fjvva/ecu-tool/Schematics/Hardware V3/HWV3.png

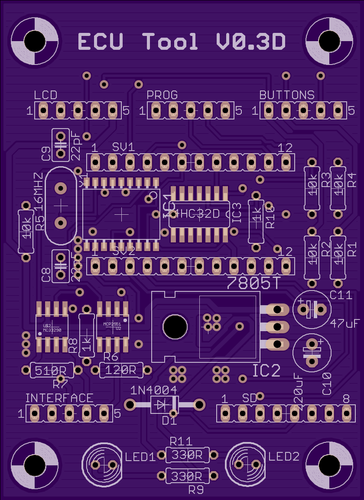
Schematics/Hardware V3/HWV3.png
