fjvva/ecu-tool/Schematics/Portable_outside.JPG

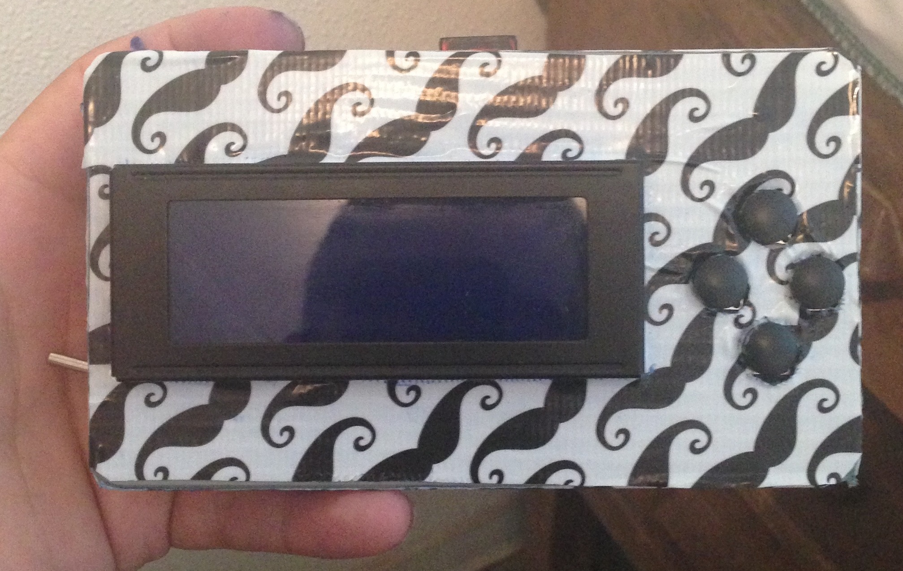
Schematics/Portable_outside.JPG
