fjvva/ecu-tool/Schematics/obd_cable_drawing.png

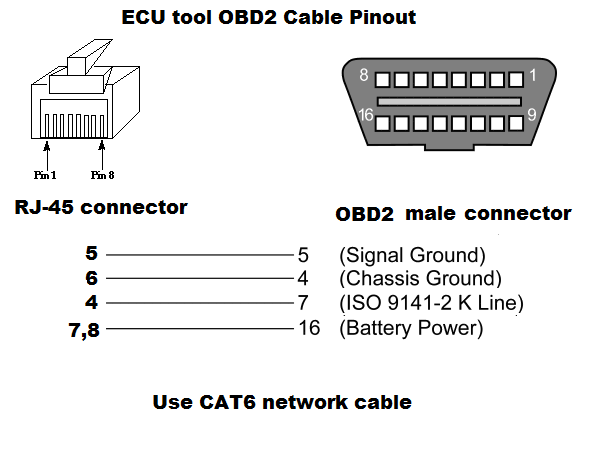
Schematics/obd_cable_drawing.png
