fjvva/ecu-tool/Schematics/Portable_Inside.JPG

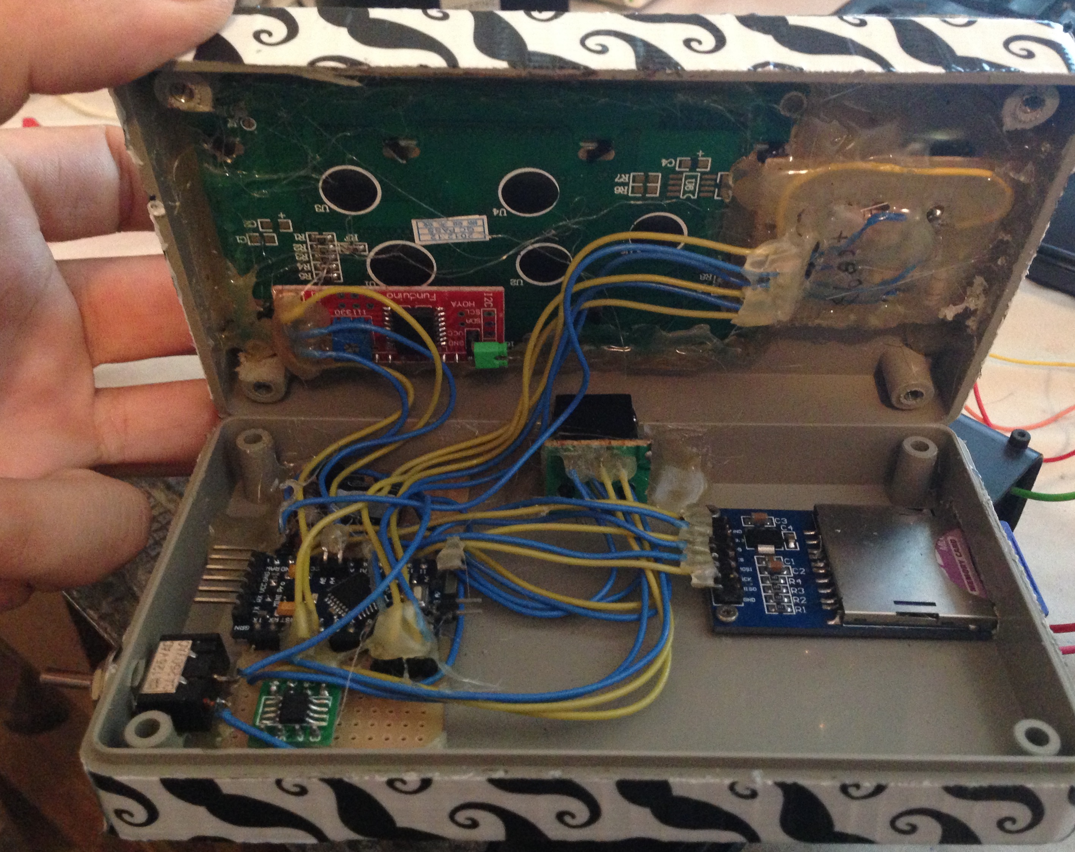
Schematics/Portable_Inside.JPG
