fjvva/ecu-tool/Schematics/programming_cable_drawing.jpg

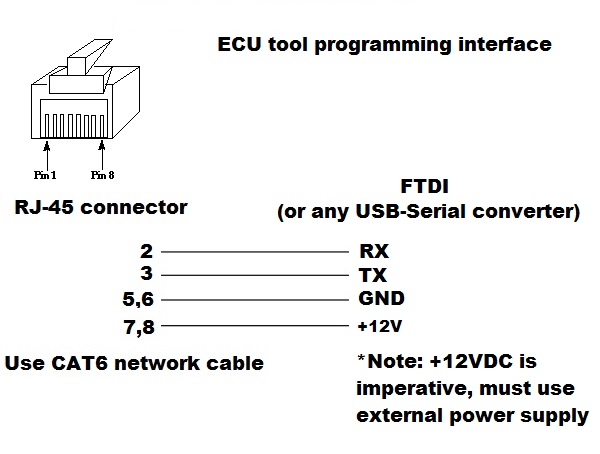
Schematics/programming_cable_drawing.jpg
