fjvva/ecu-tool/Schematics/Hardware V3/ECU tool V0.3.pdf

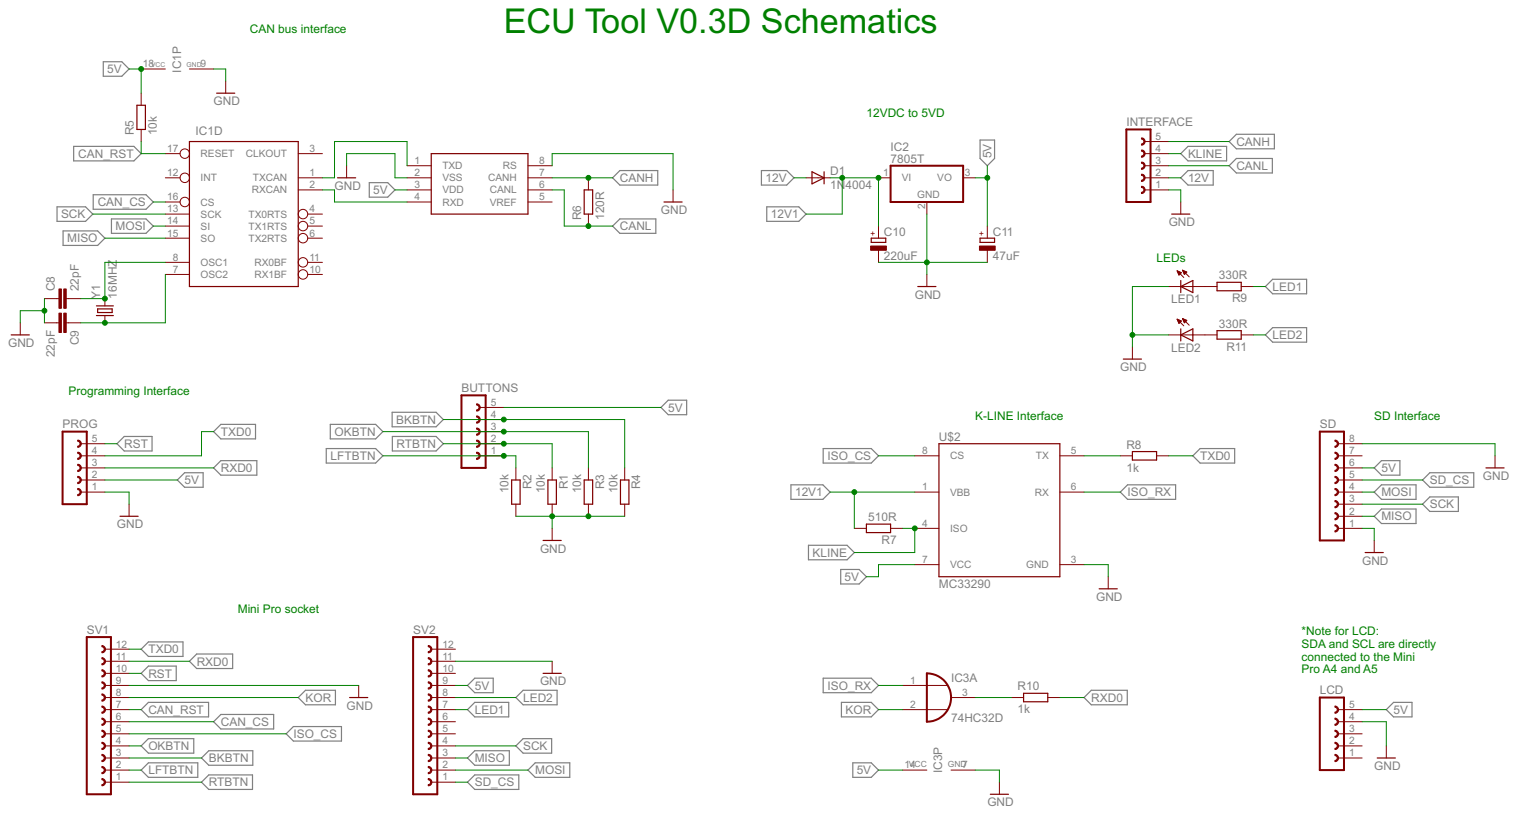
[picture p6: page 1]

*Note for LCD: SDA and SCL are directly

connected to the Mini
Pro A4 and A5
LCD
