fjvva/ecu-tool/Schematics/Hardware V1/ECU tool v0.2C_Schematics.pdf

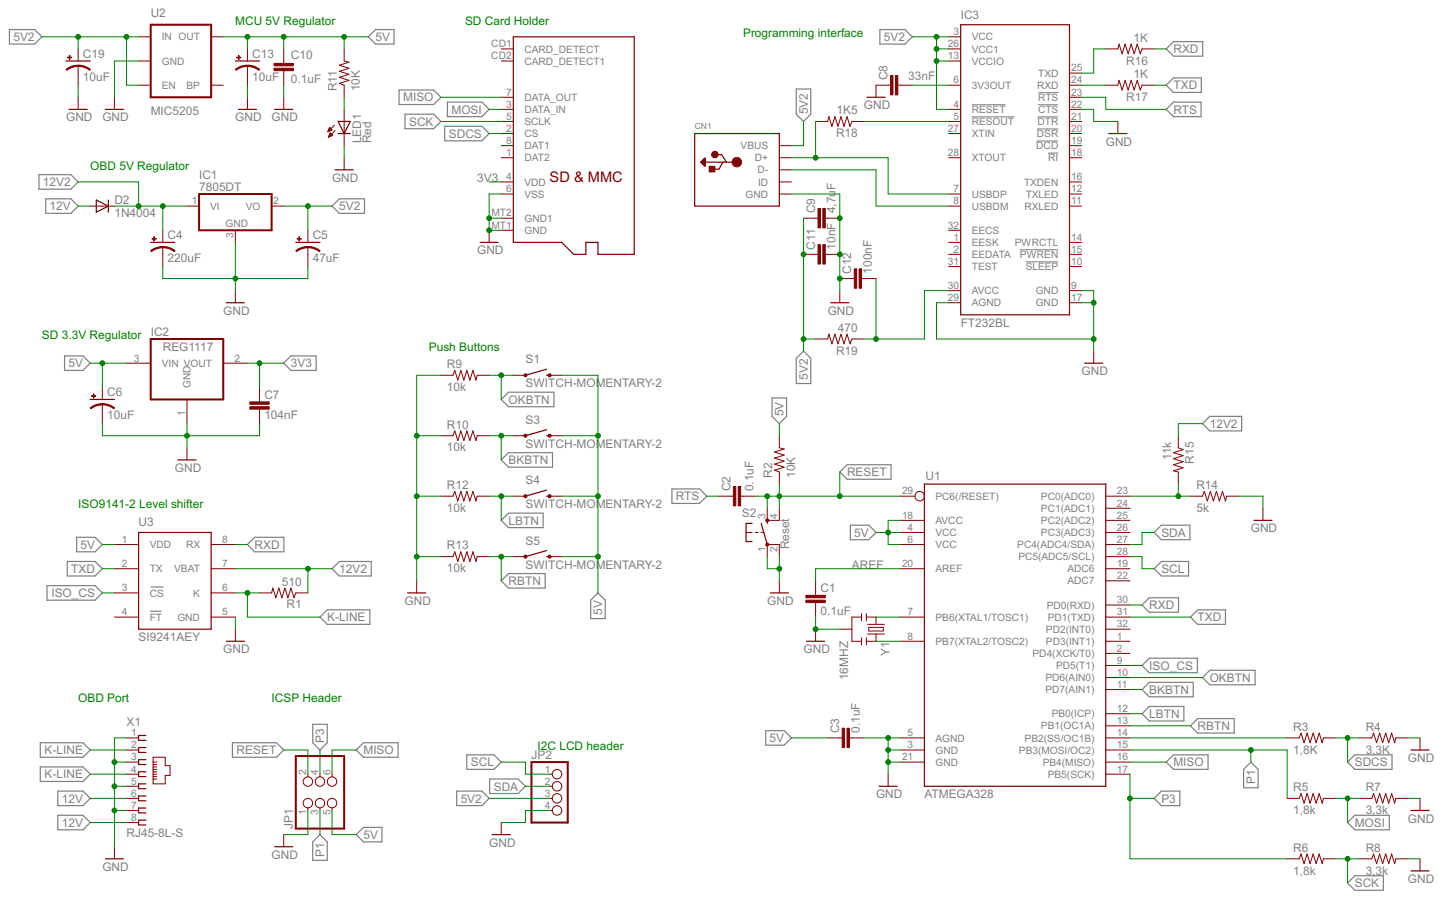
[picture p7: page 1]
