fjvva/ecu-tool/(commit log)

2013-08-06 V0.2
    Hardware for portable version of the device, graphic schematics
2013-08-31 OBD2 Cable Schematics
2013-09-02 Schematic for firmware upload cable
2014-02-15 Added first version of the KLINE Arduino lib
    This lib is meant to be used with the ECU tool
2014-12-12 Uploaded picture of HW V3 PCB
2014-12-12 Added ECU tool V0.3D schematics
